cganser/HSAFM-motor/documentation/images/Buffer_circuit.png

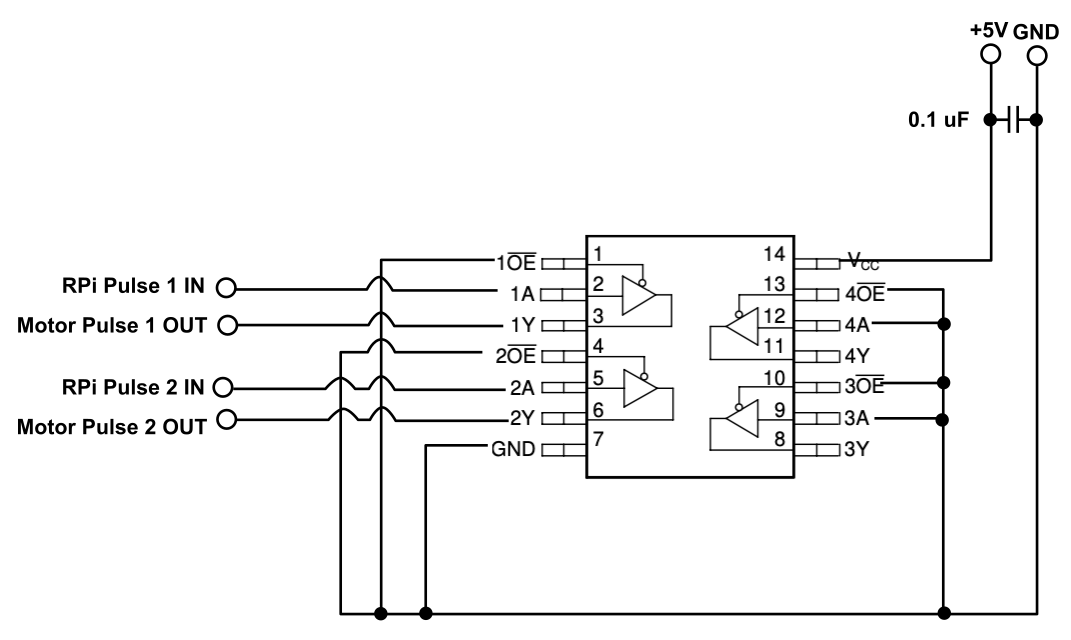
documentation/images/Buffer_circuit.png
