cganser/HSAFM-motor/documentation/images/D_Sub_pin_assignment.png

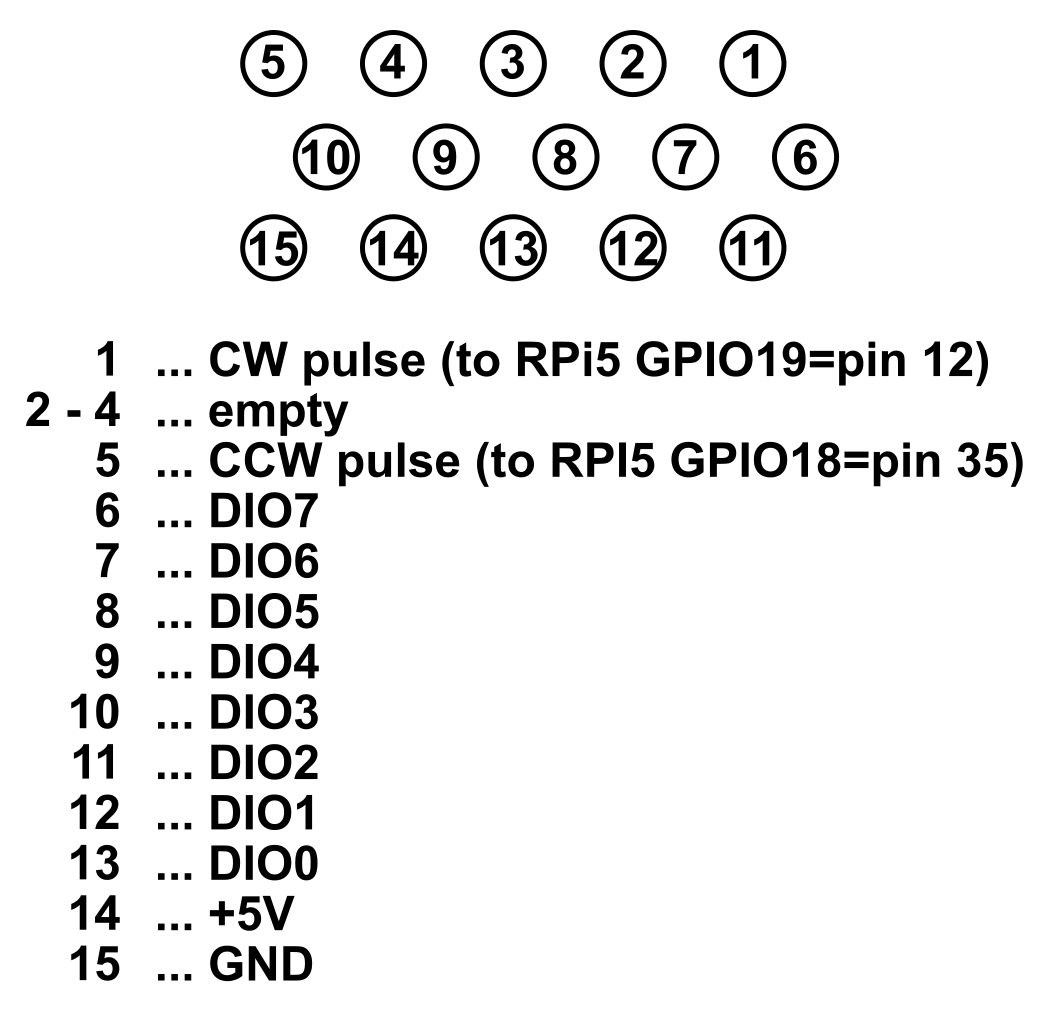
documentation/images/D_Sub_pin_assignment.png
