cganser/HSAFM-motor/documentation/images/IMG_0547.jpg

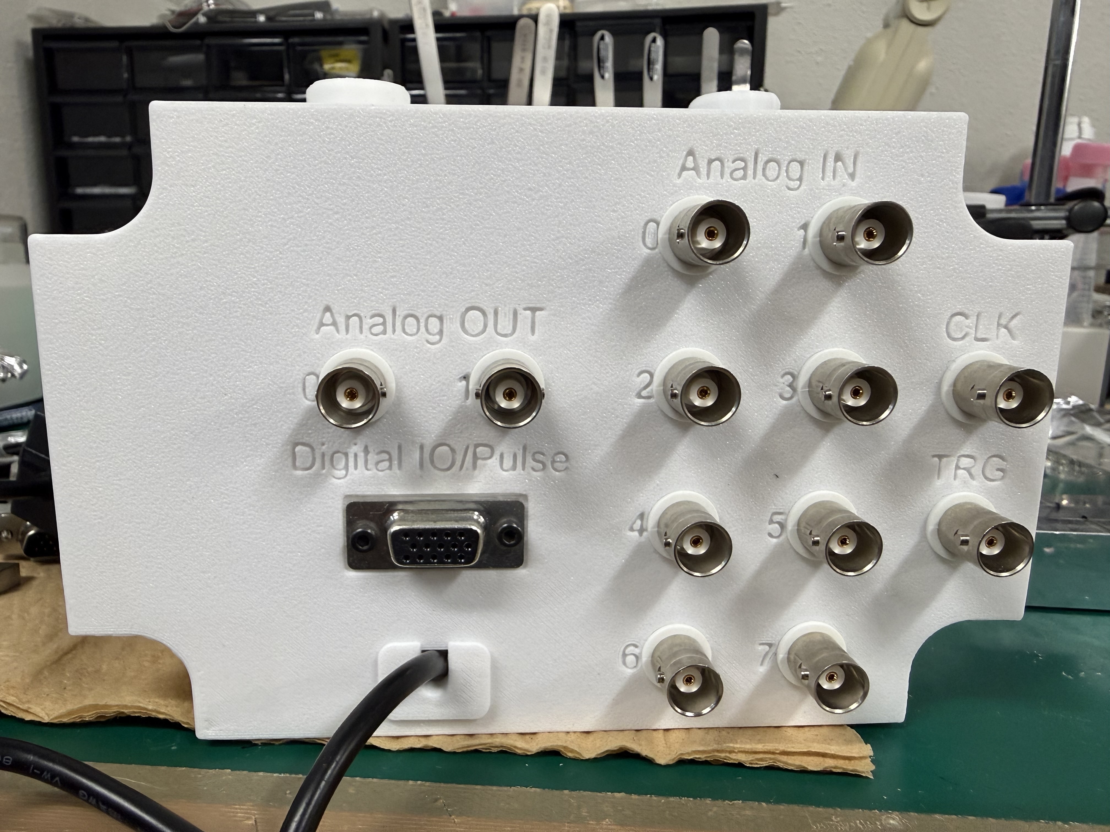
documentation/images/IMG_0547.jpg
