cganser/HSAFM-motor/documentation/images/IMG_0548.jpg

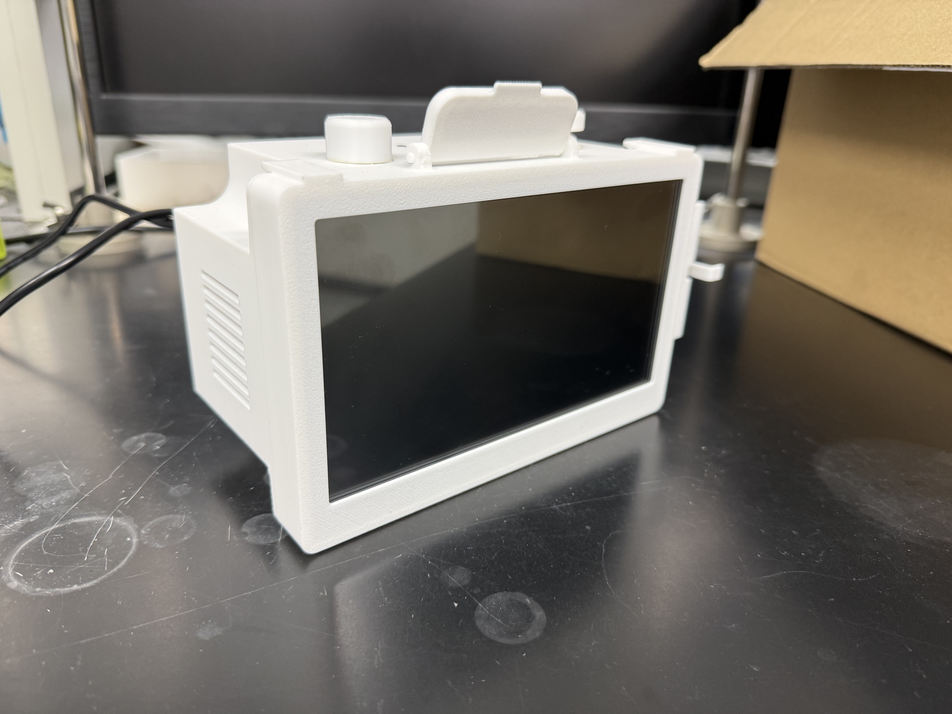
documentation/images/IMG_0548.jpg
