cganser/HSAFM-motor/documentation/images/IMG_0549.jpg

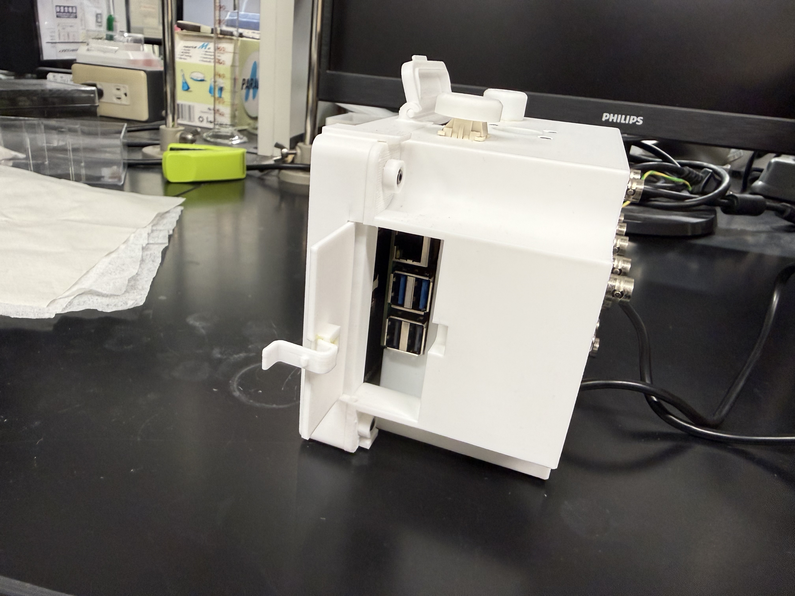
documentation/images/IMG_0549.jpg
