cganser/HSAFM-motor/documentation/images/IMG_0550.jpg

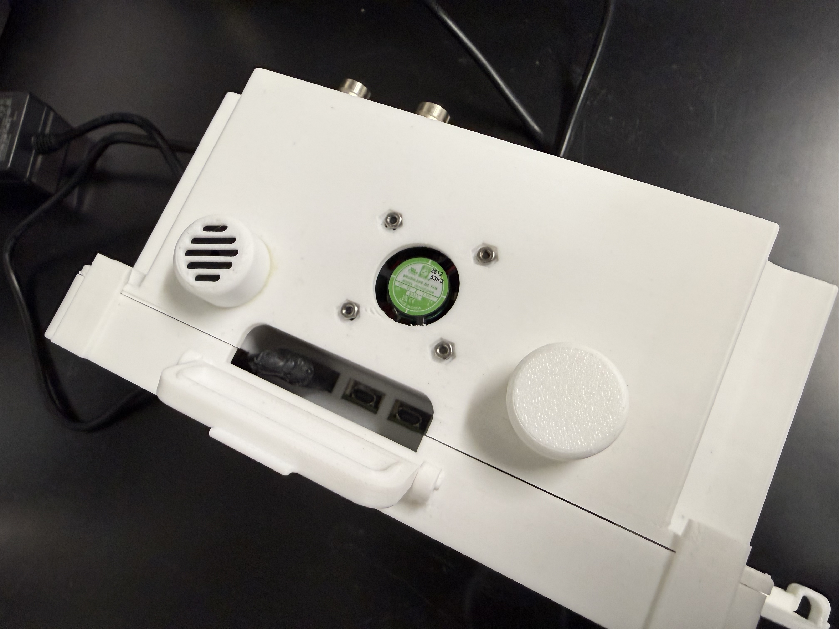
documentation/images/IMG_0550.jpg
