cganser/HSAFM-motor/documentation/images/IMG_0551.jpg

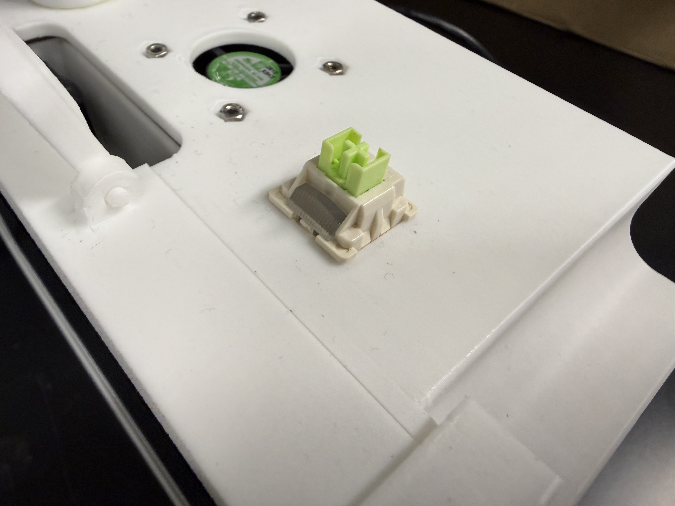
documentation/images/IMG_0551.jpg
