cganser/HSAFM-motor/documentation/images/IMG_9774.jpg

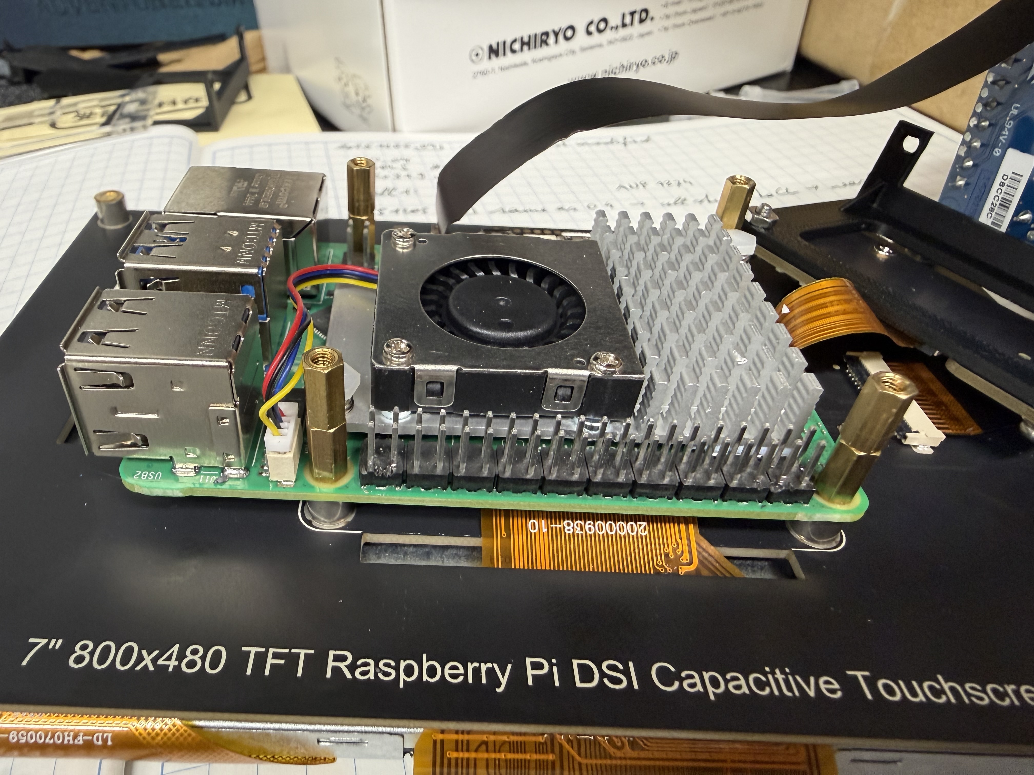
documentation/images/IMG_9774.jpg
