cganser/HSAFM-motor/documentation/images/IMG_9775.jpg

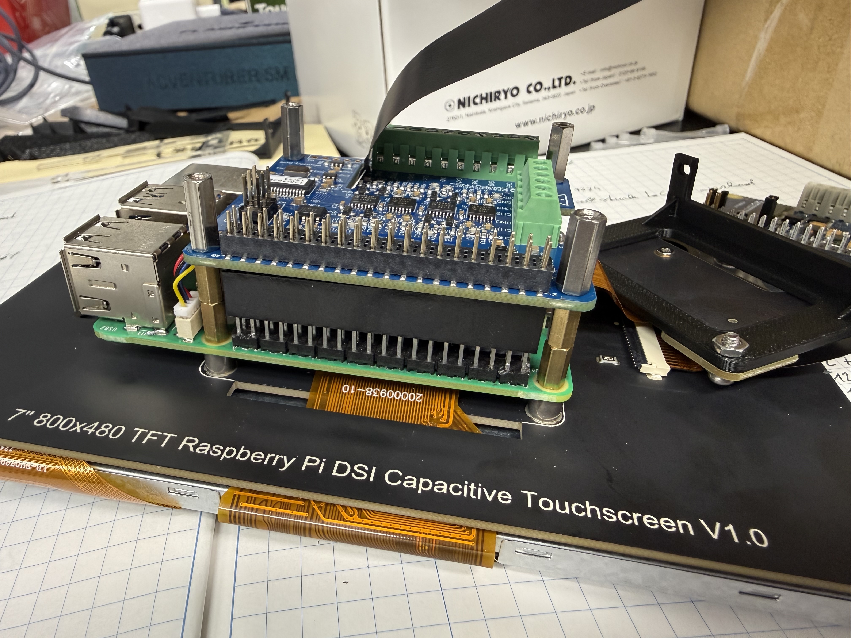
documentation/images/IMG_9775.jpg
