cganser/HSAFM-motor/documentation/images/IMG_9776.jpg

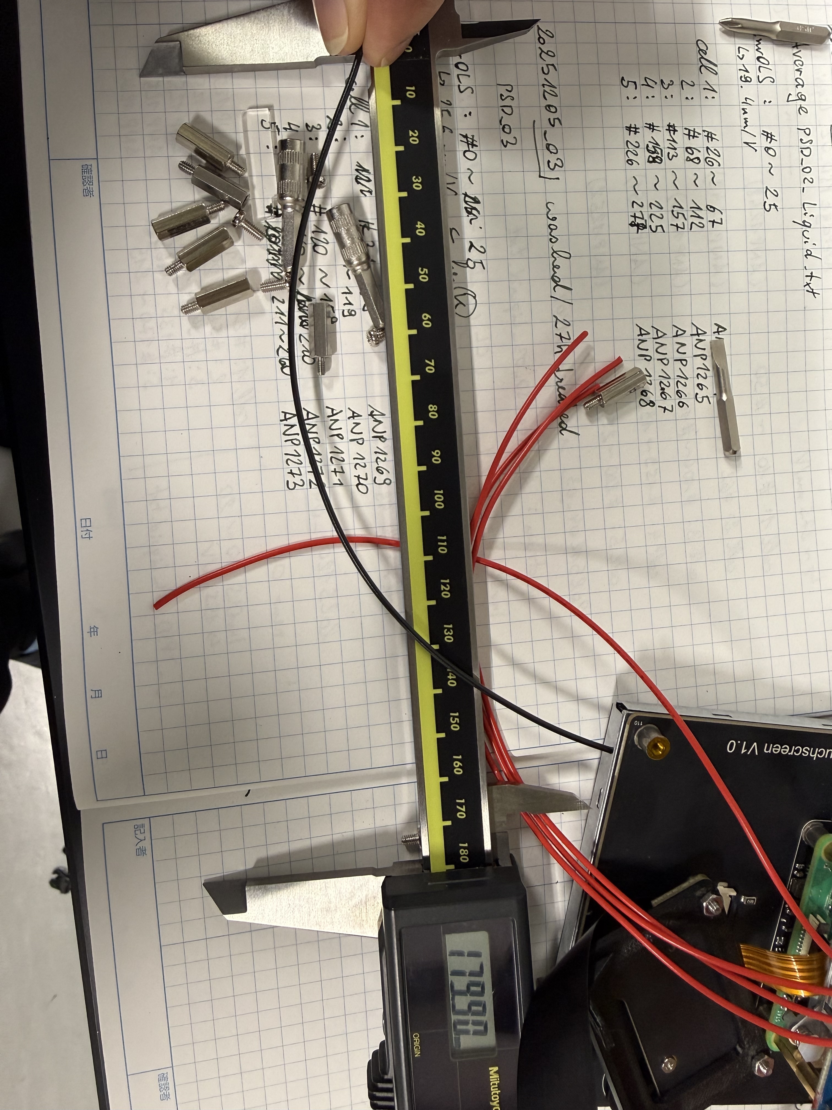
documentation/images/IMG_9776.jpg
