cganser/HSAFM-motor/documentation/images/IMG_9777.jpg

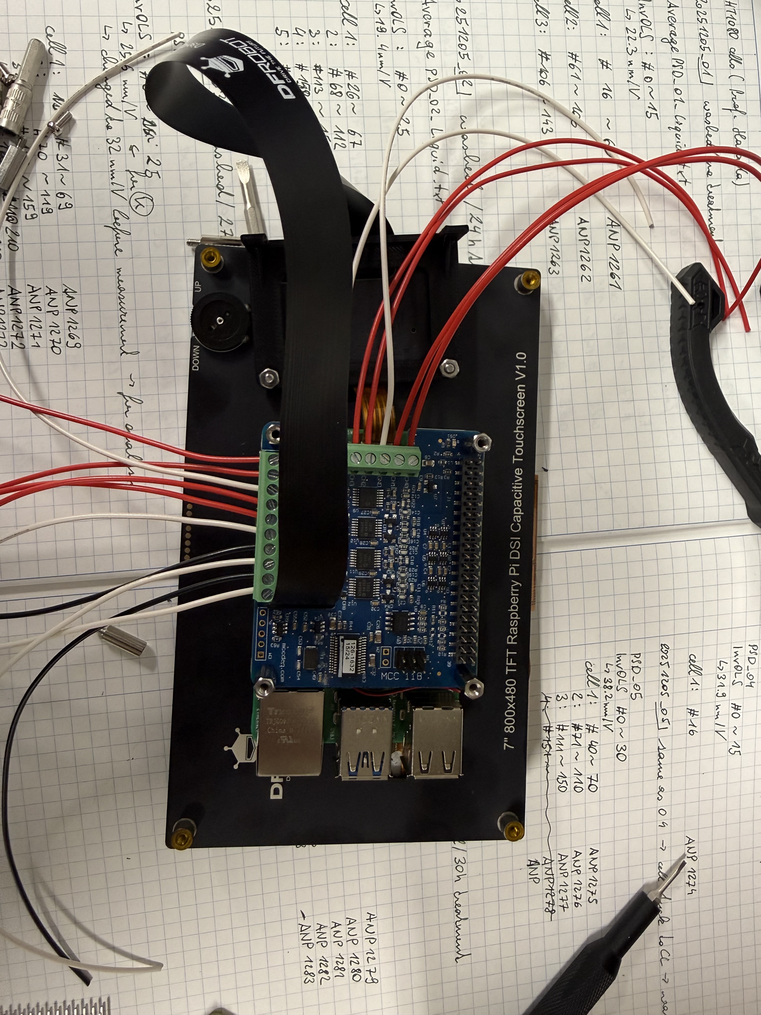
documentation/images/IMG_9777.jpg
