cganser/HSAFM-motor/documentation/images/IMG_9778.jpg

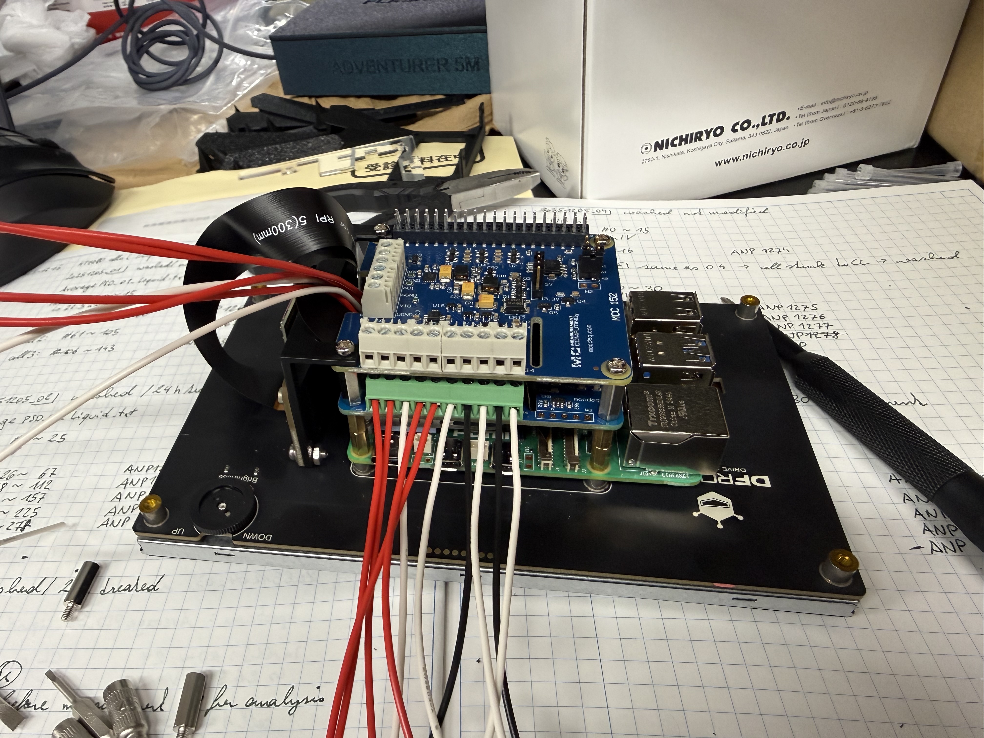
documentation/images/IMG_9778.jpg
