cganser/HSAFM-motor/documentation/images/IMG_9779.jpg

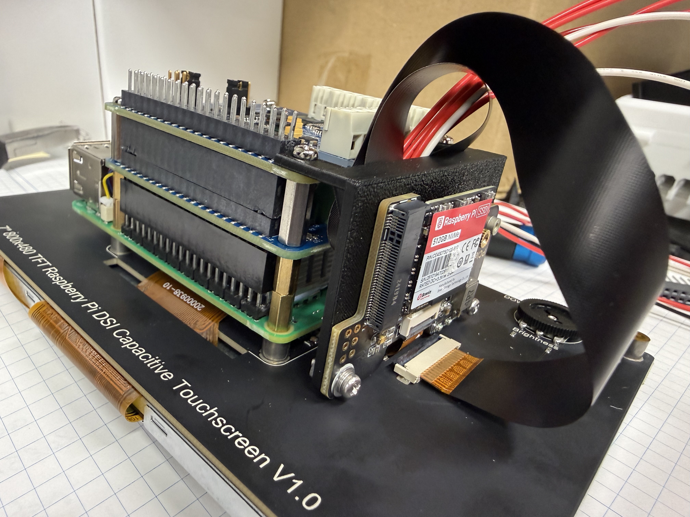
documentation/images/IMG_9779.jpg
