cganser/HSAFM-motor/documentation/images/IMG_9783.jpg

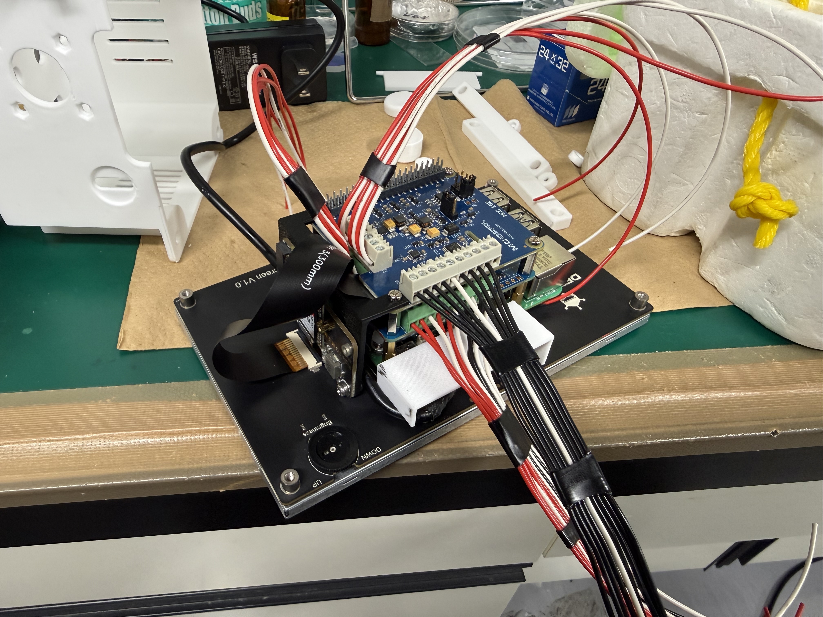
documentation/images/IMG_9783.jpg
