cganser/HSAFM-motor/documentation/images/IMG_9784.jpg

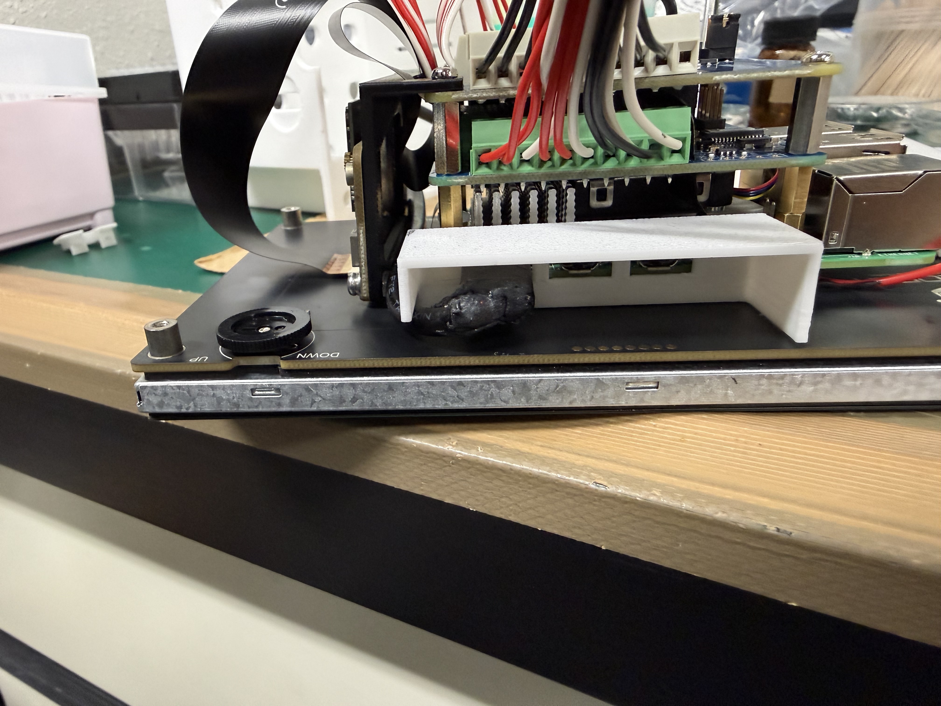
documentation/images/IMG_9784.jpg
