cganser/HSAFM-motor/documentation/images/IMG_9785.jpg

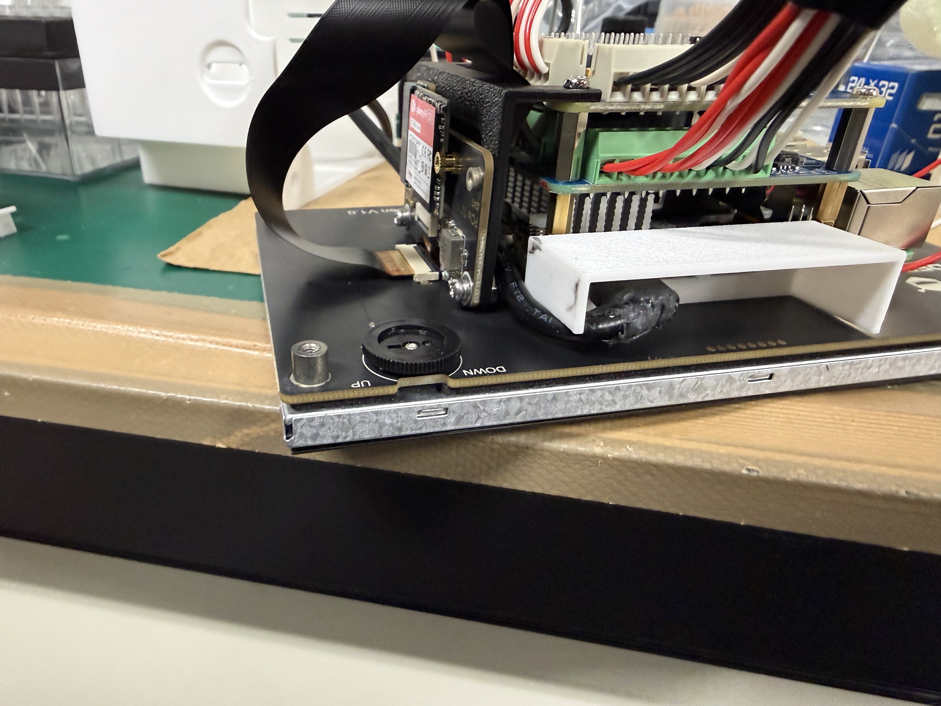
documentation/images/IMG_9785.jpg
