cganser/HSAFM-motor/documentation/images/IMG_9786.jpg

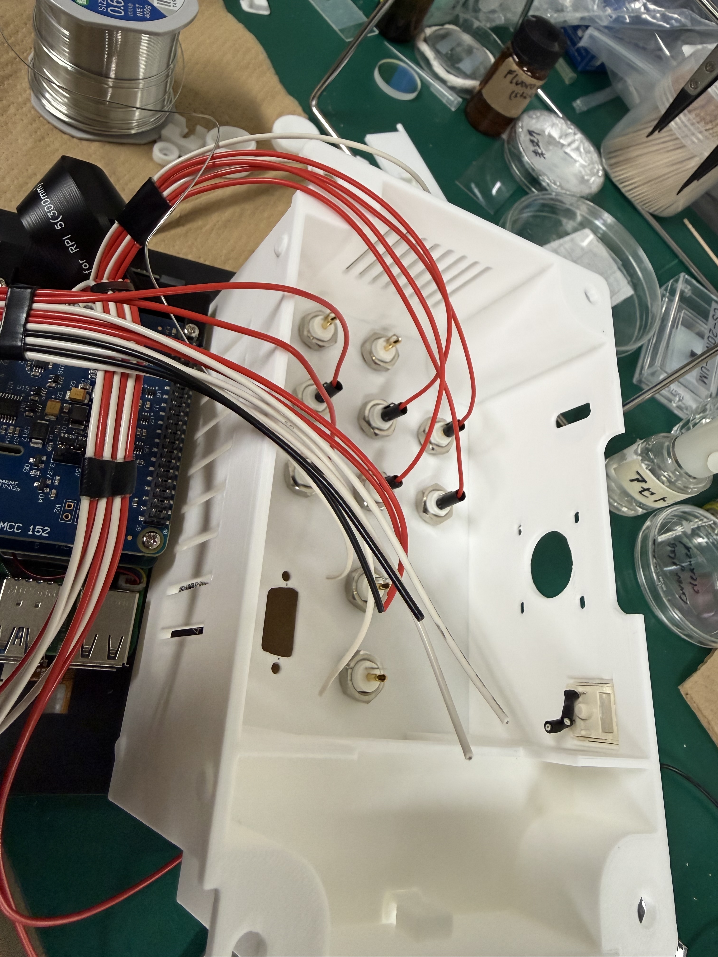
documentation/images/IMG_9786.jpg
