cganser/HSAFM-motor/documentation/3D_printables/FreeCAD/IC_case_top_V3.FCStd

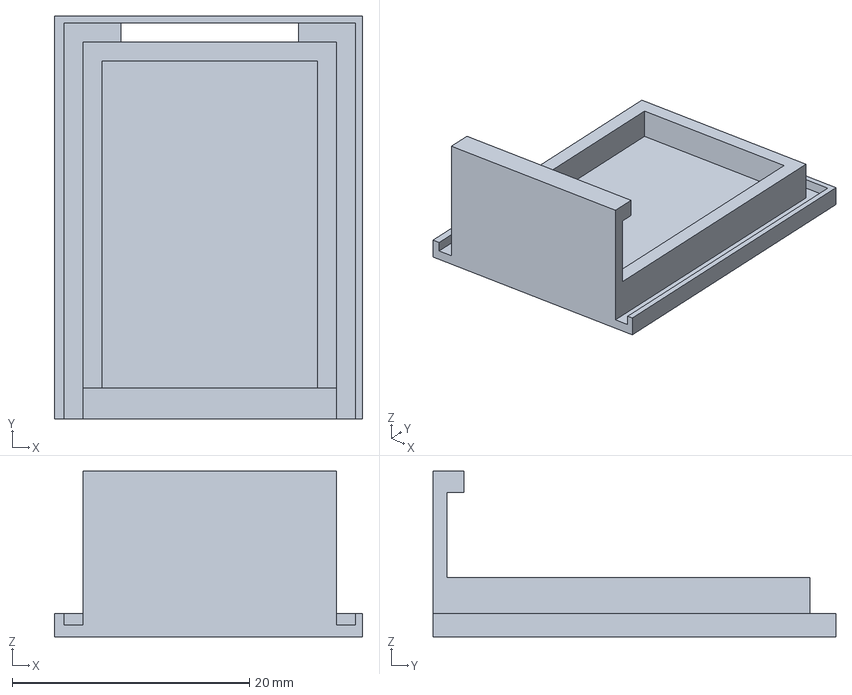
[picture p18: CAD file, 2026-10-26]
documentation/3D_printables/FreeCAD/IC_case_top_V3.FCStd
26.0 x 34.0 x 14.0 mm
