cganser/HSAFM-motor/documentation/3D_printables/STEP/power_cord_holder-Body.step

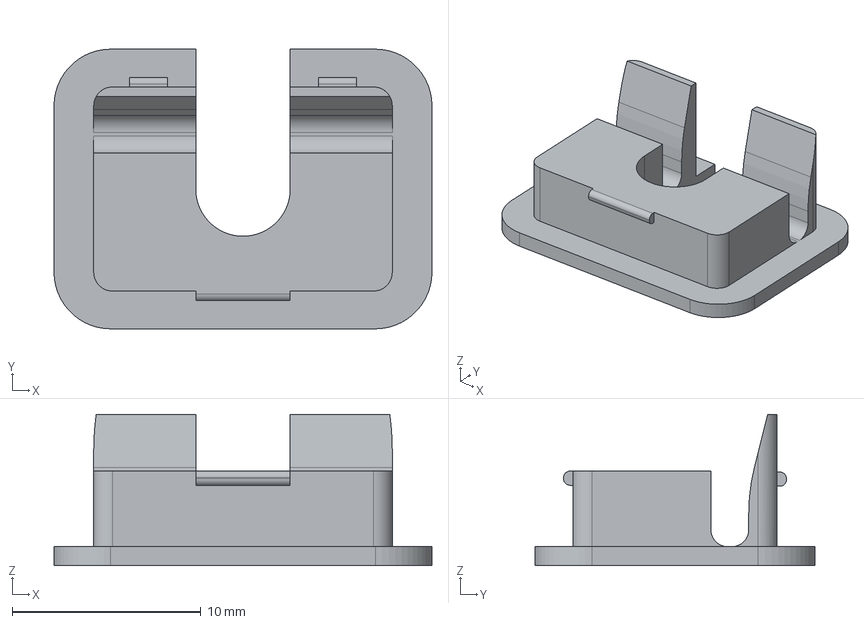
[picture p19: CAD file, 2026-10-26]
documentation/3D_printables/STEP/power_cord_holder-Body.step
20.0 x 14.8 x 8.00 mm
