cganser/HSAFM-motor/documentation/3D_printables/FreeCAD/Front_shell_v2.FCStd

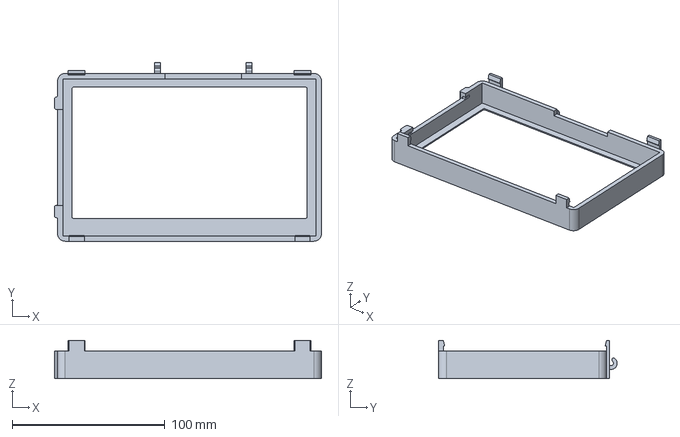
[picture p20: CAD file, 2026-10-26]
documentation/3D_printables/FreeCAD/Front_shell_v2.FCStd
175.0 x 117.0 x 25.0 mm
