cganser/HSAFM-motor/documentation/3D_printables/STEP/switch_cap-Body.step

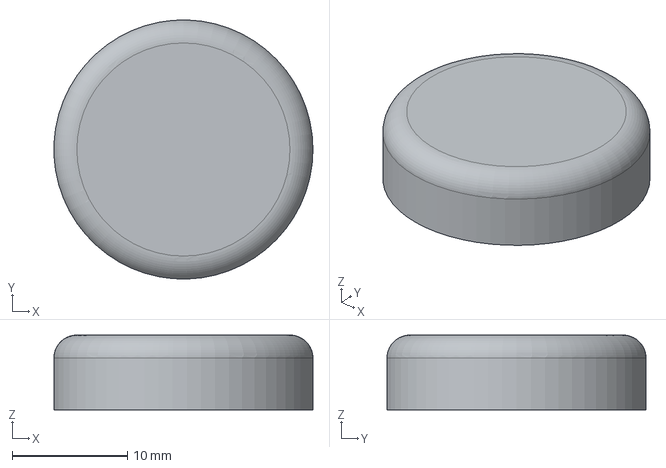
[picture p21: CAD file, 2026-10-26]
documentation/3D_printables/STEP/switch_cap-Body.step
22.5 x 22.5 x 6.50 mm
