cganser/HSAFM-motor/documentation/3D_printables/FreeCAD/buzzer_cover.FCStd

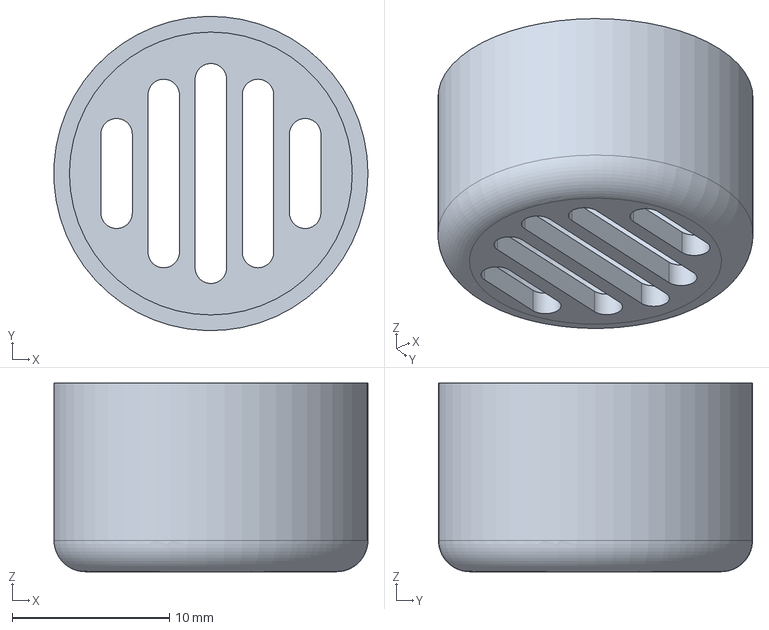
[picture p22: CAD file, 2026-10-26]
documentation/3D_printables/FreeCAD/buzzer_cover.FCStd
20.0 x 20.0 x 12.0 mm
