cganser/HSAFM-motor/documentation/3D_printables/STEP/tilt_stand_V1-Body.step

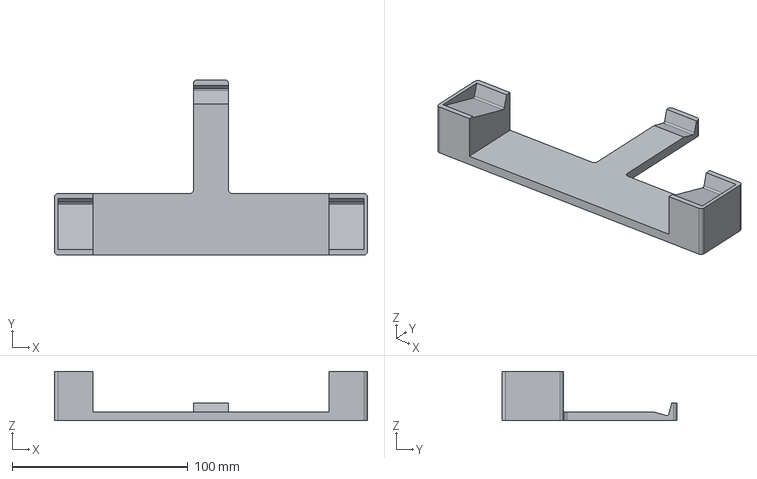
[picture p23: CAD file, 2026-10-26]
documentation/3D_printables/STEP/tilt_stand_V1-Body.step
178.0 x 99.5 x 28.0 mm
