cganser/HSAFM-motor/documentation/3D_printables/FreeCAD/IC_case_base_V3.FCStd

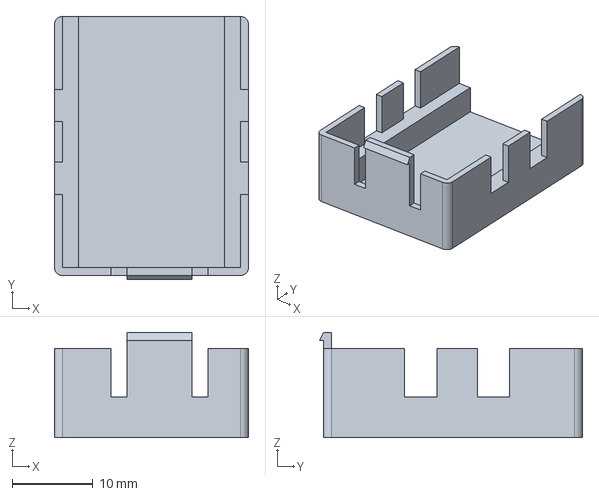
[picture p24: CAD file, 2026-10-26]
documentation/3D_printables/FreeCAD/IC_case_base_V3.FCStd
24.0 x 32.5 x 13.0 mm
