cganser/HSAFM-motor/documentation/3D_printables/STEP/DistanceBar-Body.step

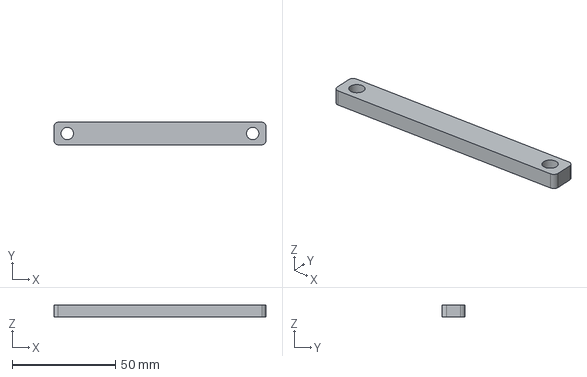
[picture p25: CAD file, 2026-10-26]
documentation/3D_printables/STEP/DistanceBar-Body.step
102.8 x 11.0 x 6.00 mm
