cganser/HSAFM-motor/documentation/3D_printables/FreeCAD/side_hatch_v2_lock.FCStd

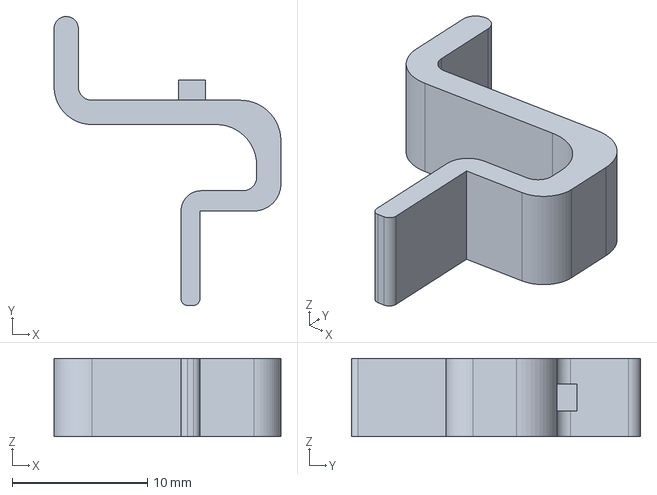
[picture p26: CAD file, 2026-10-26]
documentation/3D_printables/FreeCAD/side_hatch_v2_lock.FCStd
16.8 x 21.4 x 5.80 mm
