cganser/HSAFM-motor/documentation/3D_printables/STEP/Back_shell_txt_v2_1-Body.step

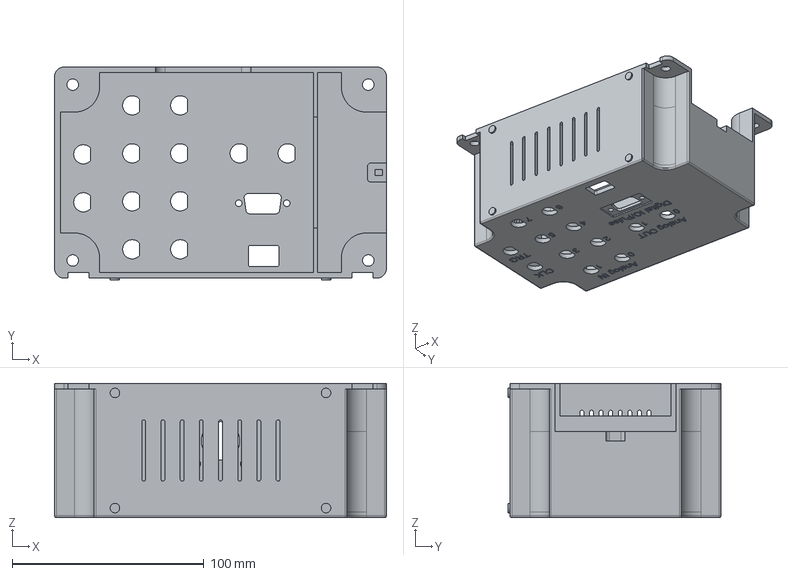
[picture p27: CAD file, 2026-10-26]
documentation/3D_printables/STEP/Back_shell_txt_v2_1-Body.step
173.0 x 111.0 x 70.0 mm
