cganser/HSAFM-motor/documentation/3D_printables/FreeCAD/SSD_holder.FCStd

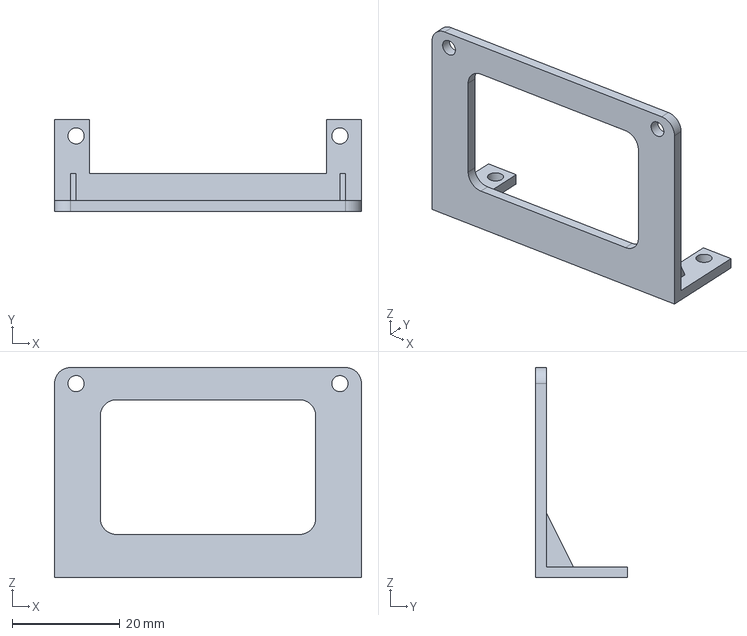
[picture p28: CAD file, 2026-10-26]
documentation/3D_printables/FreeCAD/SSD_holder.FCStd
57.0 x 17.0 x 39.0 mm
