cganser/HSAFM-motor/documentation/3D_printables/STEP/connector_cover_v2-Body.step

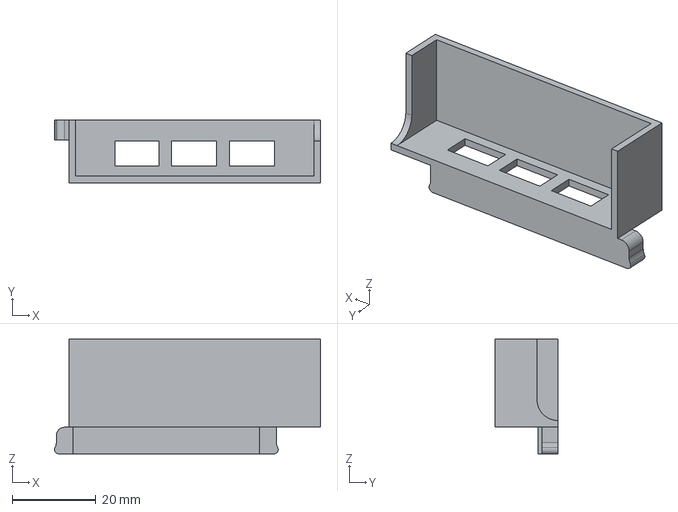
[picture p29: CAD file, 2026-10-26]
documentation/3D_printables/STEP/connector_cover_v2-Body.step
63.4 x 15.0 x 27.4 mm
