cganser/HSAFM-motor/documentation/3D_printables/STEP/SwitchCover_V3-Body.step

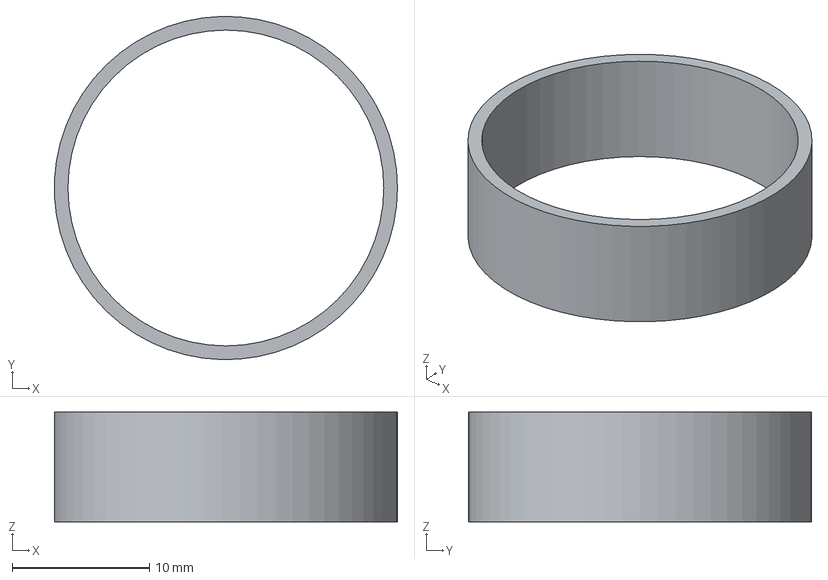
[picture p30: CAD file, 2026-10-26]
documentation/3D_printables/STEP/SwitchCover_V3-Body.step
25.0 x 25.0 x 8.00 mm
