cganser/HSAFM-motor/documentation/3D_printables/FreeCAD/side_hatch_v2_1.FCStd

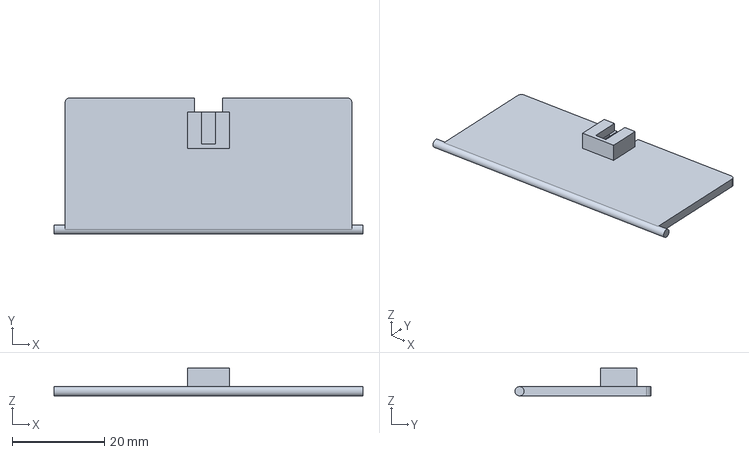
[picture p31: CAD file, 2026-10-26]
documentation/3D_printables/FreeCAD/side_hatch_v2_1.FCStd
67.0 x 29.5 x 6.00 mm
