cganser/HSAFM-motor/documentation/3D_printables/STEP/Front_shell_v2-Body.step

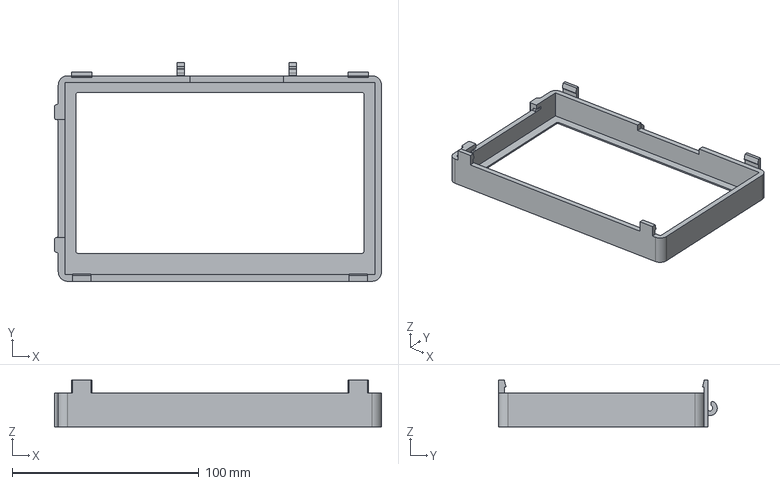
[picture p32: CAD file, 2026-10-26]
documentation/3D_printables/STEP/Front_shell_v2-Body.step
175.0 x 117.0 x 25.0 mm
