cganser/HSAFM-motor/documentation/3D_printables/FreeCAD/TopHatchV2.FCStd

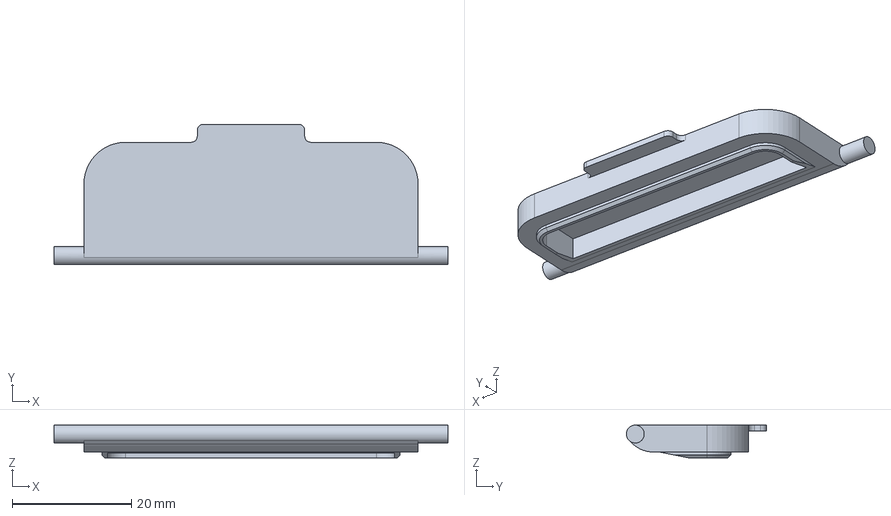
[picture p33: CAD file, 2026-10-26]
documentation/3D_printables/FreeCAD/TopHatchV2.FCStd
66.0 x 23.5 x 5.50 mm
