cganser/HSAFM-motor/(list of files, cad)

Other CAD files:
documentation/3D_printables/FreeCAD/power_cord_holder.FCStd
documentation/3D_printables/STEP/buzzer_cover-Body.step
documentation/3D_printables/FreeCAD/tilt_stand_V1.FCStd
documentation/3D_printables/FreeCAD/switch_cap.FCStd
documentation/3D_printables/STEP/IC_case_base_V3-Body.step
documentation/3D_printables/FreeCAD/connector_cover_v2.FCStd
documentation/3D_printables/STEP/IC_case_top_V3-Body.step
documentation/3D_printables/FreeCAD/DistanceBar.FCStd
documentation/3D_printables/STEP/side_hatch_v2_1-Body.step
documentation/3D_printables/STEP/side_hatch_v2_lock-Body.step
documentation/3D_printables/FreeCAD/SwitchCover_V3.FCStd
documentation/3D_printables/STEP/TopHatchV2-Body.step
documentation/3D_printables/FreeCAD/Back_shell_txt_v2_1.FCStd
documentation/3D_printables/STEP/SSD_holder-Body.step
documentation/3D_printables/FreeCAD/ScrewStopper.FCStd
documentation/3D_printables/STEP/ScrewStopper-Body.step
