cganser/HSAFM-motor/(commit log)

2025-06-20 First usable version of the RPi5 motor control
2025-08-22 Added buzzer sound after auto approach is completed
    Using either and active or passive buzzer, a sound will play to singal
    that the auto approach has finished.
    [buzzer.py, motor_control.py]
2025-08-25 Force curves are now saved automatically to the disk
    The folder is "~/force_curves/" and each force curve is then saved in a
    folder named after the current date.
2026-02-10 Added case fan control and changed z-piezo display to +/- 5V
    The bar inidcator for the z-piezo is now limited to +/-5V.
    The possibility to control the case fan from the software has been
    added. The case fan can either be switched on or off using the DIO7
    channel or some of the GPIO channels. This requires hardware
    configuration (e.g. connecting the fan to the respective channel).
    DIO7 can directly drive the fan, however, the GPIO channels cannot. In
    that case we need a PWM controllable fan. So, the fan will be driven by
    the 5V output and only switched on and off by GPIO.
2026-02-10 Fixed issue with fan control channel not being saved.
    [motor_control.py]
2026-02-10 Fixed crash when fan channel was not present in save file.
    [motor_control.py]
2026-02-10 Fixed crashes with force curve function.
    [motor_control.py]
2026-10-26 Added assembly instructions.
2026-10-26 Added 3D printables.
2026-10-26 Add hardware setup and wiring documentation
2026-10-27 Document Raspberry Pi software installation
2026-10-27 Document Pi 5 case power switch connection
